bearflip128/Smart-Puck-Public/hardware/Smart-Puck-Final-Fall-26.3mf

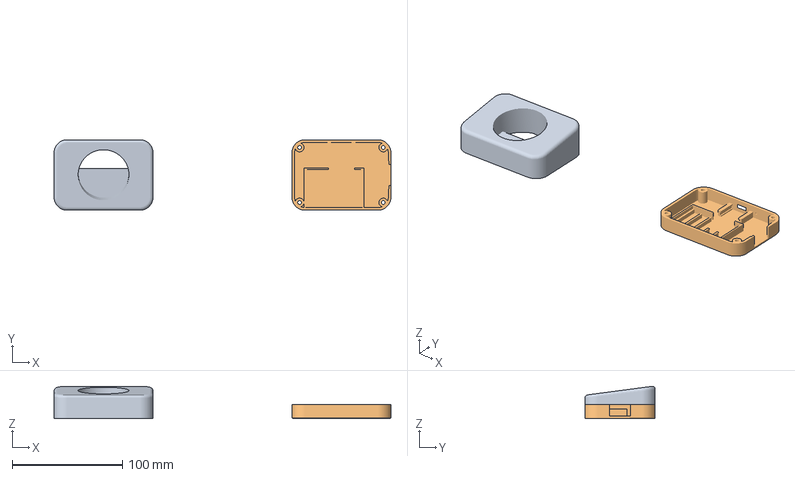
[picture p7: CAD file, 2026-11-11]
hardware/Smart-Puck-Final-Fall-26.3mf
306.0 x 64.0 x 29.3 mm
puck_lid (4).stl
puck_tub (10).stl
