bearflip128/Smart-Puck-Public/hardware/stl/fit_test_knob_hole_46.0-46.6.stl

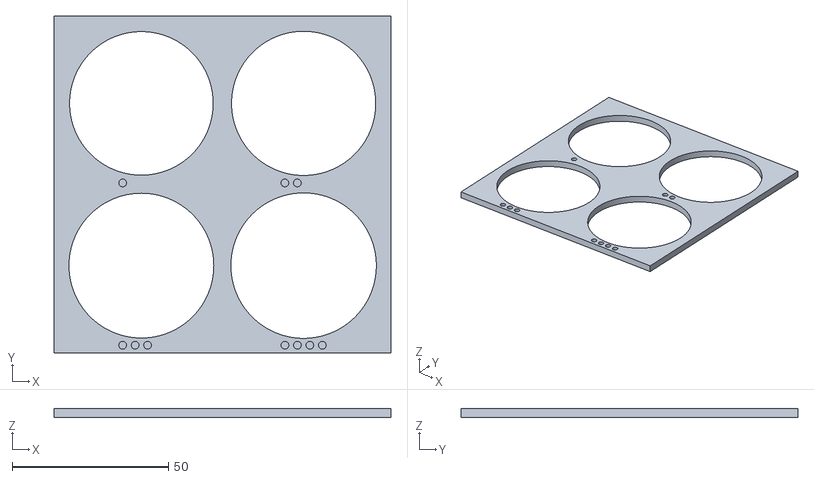
[picture p8: CAD file, 2026-11-11]
hardware/stl/fit_test_knob_hole_46.0-46.6.stl
108.0 x 108.0 x 3.00
