bearflip128/Smart-Puck-Public/hardware/stl/puck_lid.stl

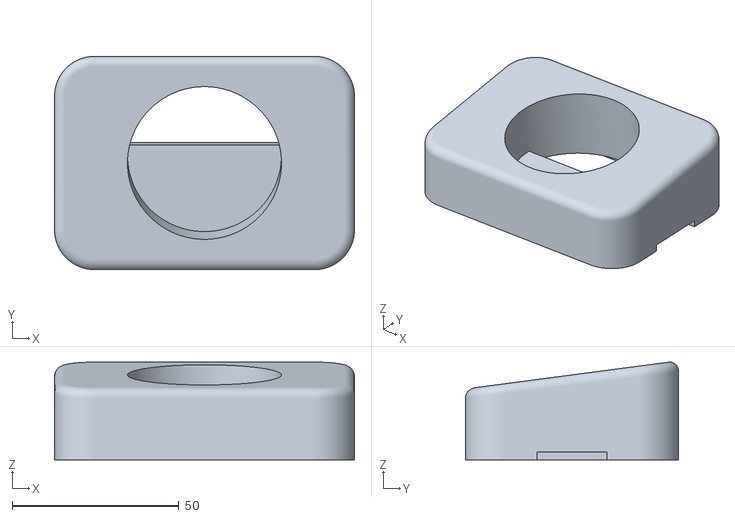
[picture p9: CAD file, 2026-11-11]
hardware/stl/puck_lid.stl
90.0 x 64.0 x 29.3
