bearflip128/Smart-Puck-Public/hardware/stl/puck_tub.stl

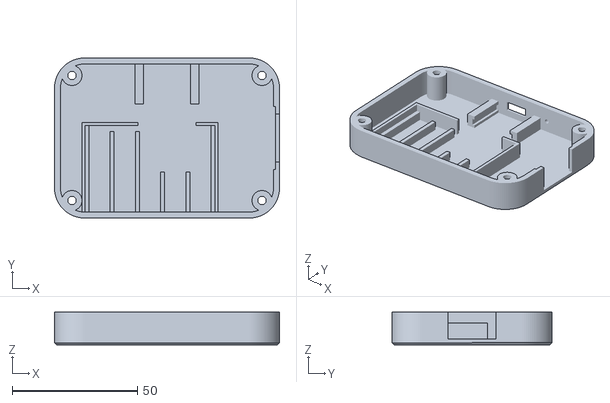
[picture p10: CAD file, 2026-11-11]
hardware/stl/puck_tub.stl
90.0 x 64.0 x 13.0
