bearflip128/Smart-Puck-Public/firmware/src/spotify_roots.h

// Root certificates the puck trusts for Spotify, so it verifies the server before sending its
// refresh token. SHA-256 fingerprints are in the comments.
#pragma once

static const char SPOTIFY_ROOTS[] =
    // Starfield Root Certificate Authority - G2 (accounts.spotify.com): 2CE1CB0BF9D2F9E102993FBE215152C3B2DD0CABDE1C68E5319B839154DBB7F5
    "-----BEGIN CERTIFICATE-----\n"
    "MIID3TCCAsWgAwIBAgIBADANBgkqhkiG9w0BAQsFADCBjzELMAkGA1UEBhMCVVMx\n"
    "EDAOBgNVBAgTB0FyaXpvbmExEzARBgNVBAcTClNjb3R0c2RhbGUxJTAjBgNVBAoT\n"
    "HFN0YXJmaWVsZCBUZWNobm9sb2dpZXMsIEluYy4xMjAwBgNVBAMTKVN0YXJmaWVs\n"
    "ZCBSb290IENlcnRpZmljYXRlIEF1dGhvcml0eSAtIEcyMB4XDTA5MDkwMTAwMDAw\n"
    "MFoXDTM3MTIzMTIzNTk1OVowgY8xCzAJBgNVBAYTAlVTMRAwDgYDVQQIEwdBcml6\n"
    "b25hMRMwEQYDVQQHEwpTY290dHNkYWxlMSUwIwYDVQQKExxTdGFyZmllbGQgVGVj\n"
    "aG5vbG9naWVzLCBJbmMuMTIwMAYDVQQDEylTdGFyZmllbGQgUm9vdCBDZXJ0aWZp\n"
    "Y2F0ZSBBdXRob3JpdHkgLSBHMjCCASIwDQYJKoZIhvcNAQEBBQADggEPADCCAQoC\n"
    "ggEBAL3twQP89o/8ArFvW59I2Z154qK3A2FWGMNHttfKPTUuiUP3oWmb3ooa/RMg\n"
    "nLRJdzIpVv257IzdIvpy3Cdhl+72WoTsbhm5iSzchFvVdPtrX8WJpRBSiUZV9Lh1\n"
    "HOZ/5FSuS/hVclcCGfgXcVnrHigHdMWdSL5stPSksPNkN3mSwOxGXn/hbVNMYq/N\n"
    "Hwtjuzqd+/x5AJhhdM8mgkBj87JyahkNmcrUDnXMN/uLicFZ8WJ/X7NfZTD4p7dN\n"
    "dloedl40wOiWVpmKs/B/pM293DIxfJHP4F8R+GuqSVzRmZTRouNjWwl2tVZi4Ut0\n"
    "HZbUJtQIBFnQmA4O5t78w+wfkPECAwEAAaNCMEAwDwYDVR0TAQH/BAUwAwEB/zAO\n"
    "BgNVHQ8BAf8EBAMCAQYwHQYDVR0OBBYEFHwMMh+n2TB/xH1oo2Kooc6rB1snMA0G\n"
    "CSqGSIb3DQEBCwUAA4IBAQARWfolTwNvlJk7mh+ChTnUdgWUXuEok21iXQnCoKjU\n"
    "sHU48TRqneSfioYmUeYs0cYtbpUgSpIB7LiKZ3sx4mcujJUDJi5DnUox9g61DLu3\n"
    "4jd/IroAow57UvtruzvE03lRTs2Q9GcHGcg8RnoNAX3FWOdt5oUwF5okxBDgBPfg\n"
    "8n/Uqgr/Qh037ZTlZFkSIHc40zI+OIF1lnP6aI+xy84fxez6nH7PfrHxBy22/L/K\n"
    "pL/QlwVKvOoYKAKQvVR4CSFx09F9HdkWsKlhPdAKACL8x3vLCWRFCztAgfd9fDL1\n"
    "mMpYjn0q7pBZc2T5NnReJaH1ZgUufzkVqSr7UIuOhWn0\n"
    "-----END CERTIFICATE-----\n"
    // DigiCert Global Root G2 (api.spotify.com): CB3CCBB76031E5E0138F8DD39A23F9DE47FFC35E43C1144CEA27D46A5AB1CB5F
    "-----BEGIN CERTIFICATE-----\n"
    "MIIDjjCCAnagAwIBAgIQAzrx5qcRqaC7KGSxHQn65TANBgkqhkiG9w0BAQsFADBh\n"
    "MQswCQYDVQQGEwJVUzEVMBMGA1UEChMMRGlnaUNlcnQgSW5jMRkwFwYDVQQLExB3\n"
    "d3cuZGlnaWNlcnQuY29tMSAwHgYDVQQDExdEaWdpQ2VydCBHbG9iYWwgUm9vdCBH\n"
    "MjAeFw0xMzA4MDExMjAwMDBaFw0zODAxMTUxMjAwMDBaMGExCzAJBgNVBAYTAlVT\n"
    "MRUwEwYDVQQKEwxEaWdpQ2VydCBJbmMxGTAXBgNVBAsTEHd3dy5kaWdpY2VydC5j\n"
    "b20xIDAeBgNVBAMTF0RpZ2lDZXJ0IEdsb2JhbCBSb290IEcyMIIBIjANBgkqhkiG\n"
    "9w0BAQEFAAOCAQ8AMIIBCgKCAQEAuzfNNNx7a8myaJCtSnX/RrohCgiN9RlUyfuI\n"
    "2/Ou8jqJkTx65qsGGmvPrC3oXgkkRLpimn7Wo6h+4FR1IAWsULecYxpsMNzaHxmx\n"
    "1x7e/dfgy5SDN67sH0NO3Xss0r0upS/kqbitOtSZpLYl6ZtrAGCSYP9PIUkY92eQ\n"
    "q2EGnI/yuum06ZIya7XzV+hdG82MHauVBJVJ8zUtluNJbd134/tJS7SsVQepj5Wz\n"
    "tCO7TG1F8PapspUwtP1MVYwnSlcUfIKdzXOS0xZKBgyMUNGPHgm+F6HmIcr9g+UQ\n"
    "vIOlCsRnKPZzFBQ9RnbDhxSJITRNrw9FDKZJobq7nMWxM4MphQIDAQABo0IwQDAP\n"
    "BgNVHRMBAf8EBTADAQH/MA4GA1UdDwEB/wQEAwIBhjAdBgNVHQ4EFgQUTiJUIBiV\n"
    "5uNu5g/6+rkS7QYXjzkwDQYJKoZIhvcNAQELBQADggEBAGBnKJRvDkhj6zHd6mcY\n"
    "1Yl9PMWLSn/pvtsrF9+wX3N3KjITOYFnQoQj8kVnNeyIv/iPsGEMNKSuIEyExtv4\n"
    "NeF22d+mQrvHRAiGfzZ0JFrabA0UWTW98kndth/Jsw1HKj2ZL7tcu7XUIOGZX1NG\n"
    "Fdtom/DzMNU+MeKNhJ7jitralj41E6Vf8PlwUHBHQRFXGU7Aj64GxJUTFy8bJZ91\n"
    "8rGOmaFvE7FBcf6IKshPECBV1/MUReXgRPTqh5Uykw7+U0b6LJ3/iyK5S9kJRaTe\n"
    "pLiaWN0bfVKfjllDiIGknibVb63dDcY3fe0Dkhvld1927jyNxF1WW6LZZm6zNTfl\n"
    "MrY=\n"
    "-----END CERTIFICATE-----\n"
    // DigiCert Global Root G3 (i.scdn.co, album covers): 31AD6648F8104138C738F39EA4320133393E3A18CC02296EF97C2AC9EF6731D0
    "-----BEGIN CERTIFICATE-----\n"
    "MIICPzCCAcWgAwIBAgIQBVVWvPJepDU1w6QP1atFcjAKBggqhkjOPQQDAzBhMQsw\n"
    "CQYDVQQGEwJVUzEVMBMGA1UEChMMRGlnaUNlcnQgSW5jMRkwFwYDVQQLExB3d3cu\n"
    "ZGlnaWNlcnQuY29tMSAwHgYDVQQDExdEaWdpQ2VydCBHbG9iYWwgUm9vdCBHMzAe\n"
    "Fw0xMzA4MDExMjAwMDBaFw0zODAxMTUxMjAwMDBaMGExCzAJBgNVBAYTAlVTMRUw\n"
    "EwYDVQQKEwxEaWdpQ2VydCBJbmMxGTAXBgNVBAsTEHd3dy5kaWdpY2VydC5jb20x\n"
    "IDAeBgNVBAMTF0RpZ2lDZXJ0IEdsb2JhbCBSb290IEczMHYwEAYHKoZIzj0CAQYF\n"
    "K4EEACIDYgAE3afZu4q4C/sLfyHS8L6+c/MzXRq8NOrexpu80JX28MzQC7phW1FG\n"
    "fp4tn+6OYwwX7Adw9c+ELkCDnOg/QW07rdOkFFk2eJ0DQ+4QE2xy3q6Ip6FrtUPO\n"
    "Z9wj/wMco+I+o0IwQDAPBgNVHRMBAf8EBTADAQH/MA4GA1UdDwEB/wQEAwIBhjAd\n"
    "BgNVHQ4EFgQUs9tIpPmhxdiuNkHMEWNpYim8S8YwCgYIKoZIzj0EAwMDaAAwZQIx\n"
    "AK288mw/EkrRLTnDCgmXc/SINoyIJ7vmiI1Qhadj+Z4y3maTD/HMsQmP3Wyr+mt/\n"
    "oAIwOWZbwmSNuJ5Q3KjVSaLtx9zRSX8XAbjIho9OjIgrqJqpisXRAL34VOKa5Vt8\n"
    "sycX\n"
    "-----END CERTIFICATE-----\n";
