bearflip128/Smart-Puck-Public/(commit log)

2026-11-11 Smart Puck public release: hardware, firmware, simulator and build docs (#1)
    Public release of the Smart Puck: printable case (STL + generator),
    firmware 0.22.0 with computer-side tools, browser simulator, parts list,
    assembly guide and README.
    Claude-Session: https://claude.ai/code/session_01P2bNkrzDwx8BEW1EB7dvQj
    [fit_test_knob_hole_46.0-46.6.stl, puck_lid.stl, puck_tub.stl]
2026-11-11 Remove robot arm support; add Bambu Studio print project (#2)
    Drops the robot arm mode, its Wi-Fi client, certificates, tools and docs
    from the firmware, simulator and READMEs. Adds the A1 mini .3mf print
    project (account ID removed from its metadata).
    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
    [Smart-Puck-Final-Fall-26.3mf]
2026-11-11 Docs: print with tree supports, everywhere (matches the .3mf) (#3)
    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
